kiyoshigawa/oMIDItone_Controller_V2/Controller PCB/Reverse Engineering Original Board/2019-04-23_Otamatone_Board_Photos/Board_Back.pdf

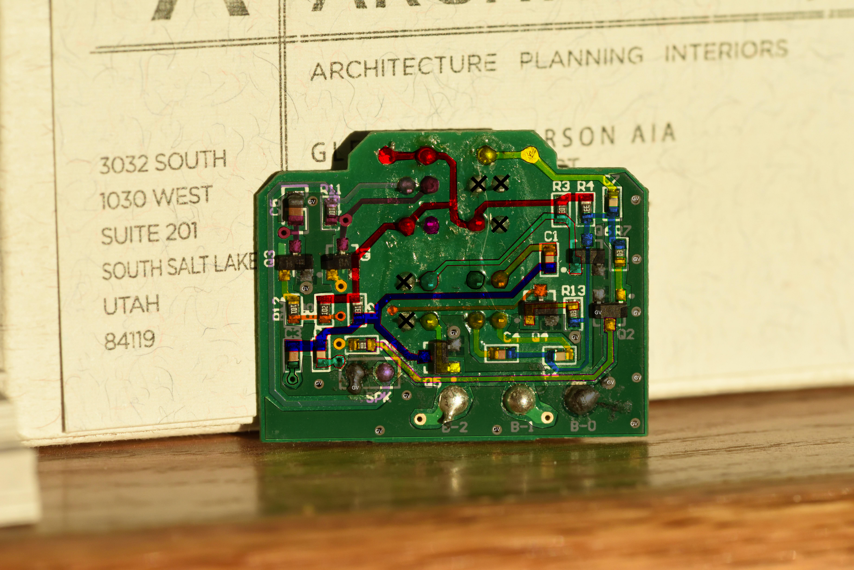
[picture p3: page 1]
