kiyoshigawa/oMIDItone_Controller_V2/Controller PCB/oMIDItone V2/oMIDItone V2 Schematic.pdf

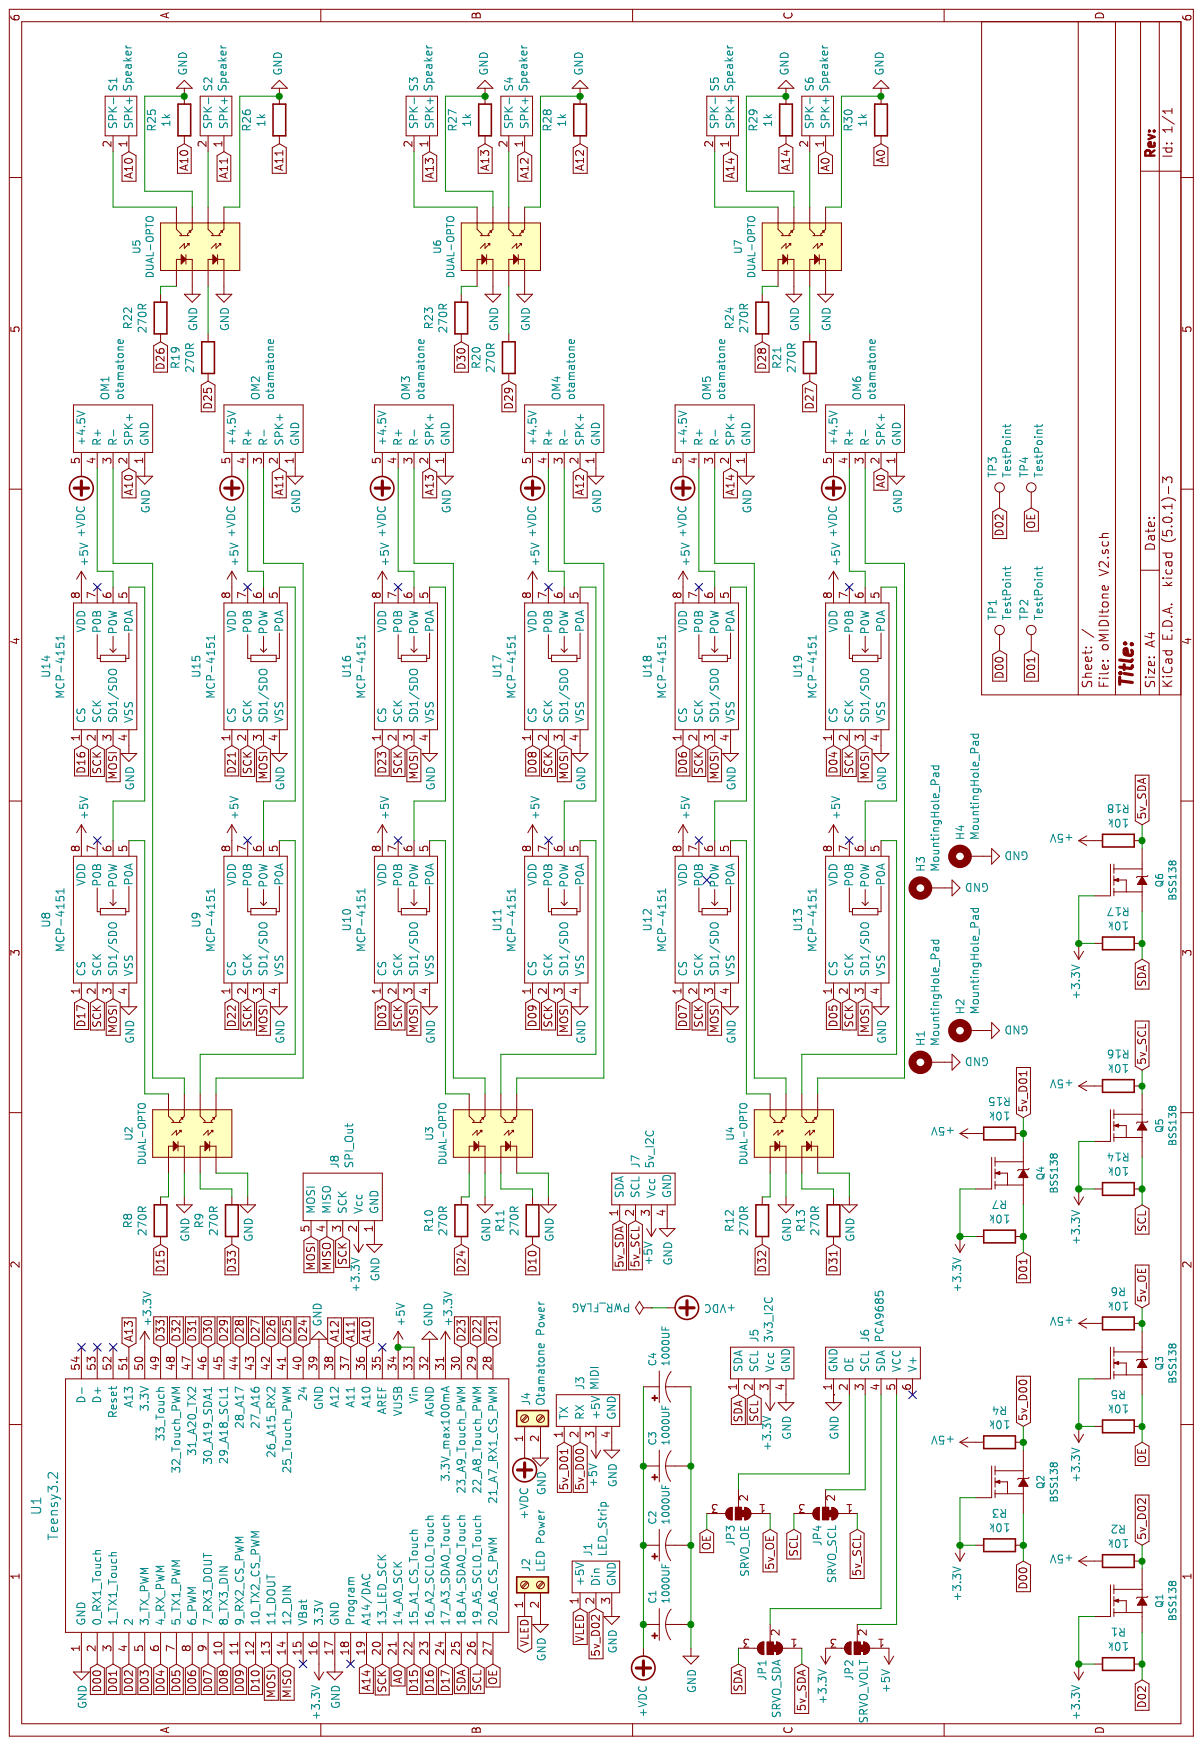
[picture p5: page 1]
