kiyoshigawa/oMIDItone_Controller_V2/Controller PCB/Reverse Engineering Original Board/RE-otamatone/RE-Otamatone-Schematic.pdf

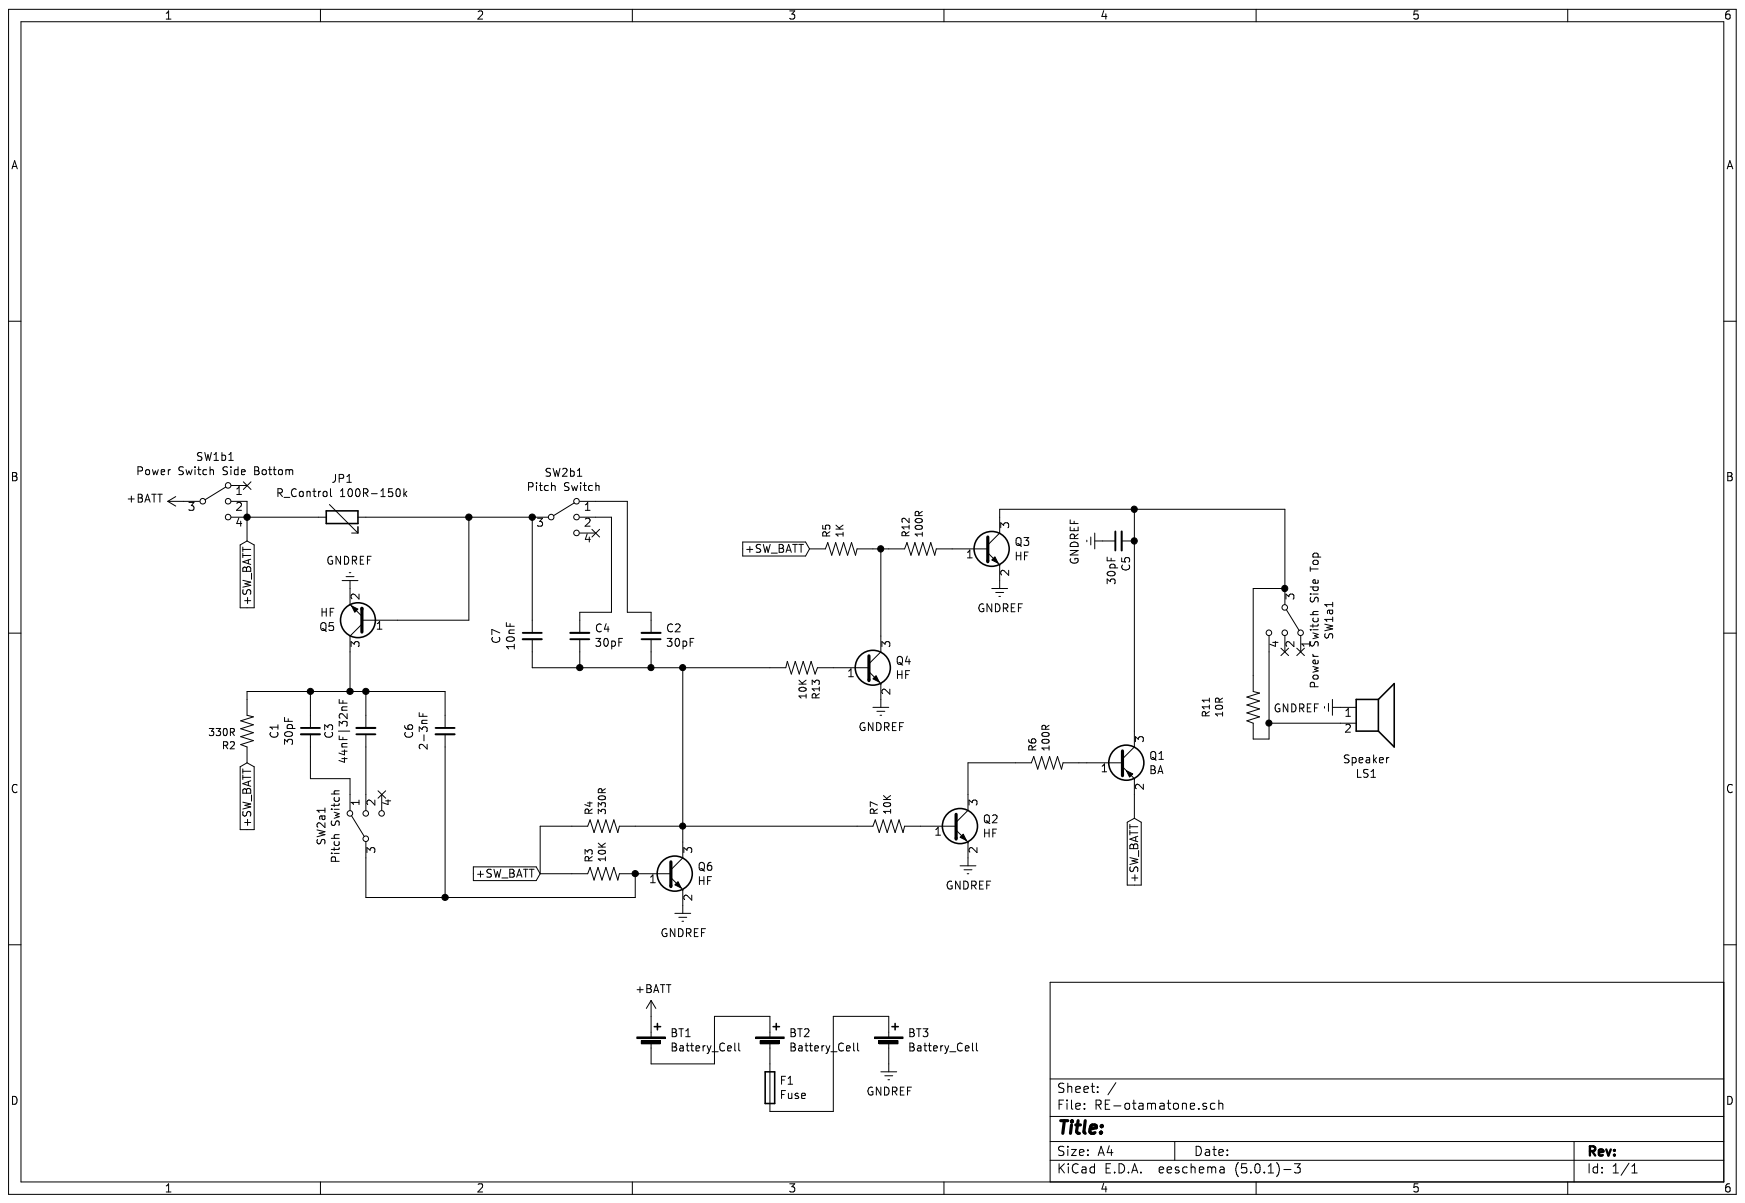
[picture p6: page 1]
