kiyoshigawa/oMIDItone_Controller_V2/include/oMIDItone.h

#define OMIDITONE_H
#include <Arduino.h>
#include <SPI.h>
#include <ADC.h>
#include <i2c_t3.h>
#include <Adafruit_PWMServoDriver.h>
#include "lighting_control.h"
#define OMIDITONE_DEBUG
#define FREQUENCY_CORRECTION_DEFAULT_ENABLE_STATE true
#define SERVO_DEFAULT_ENABLE_STATE true
#define NUM_OMIDITONES 6
#define NO_NOTE 128
#define NO_CHANNEL 17
#define NO_RESISTANCE -1
#define NOTE_A 440
#define NUM_MIDI_NOTES 128
#define NUM_MIDI_CHANNELS 16
#define NUM_RESISTANCE_STEPS 765
#define RISING_EDGE_THRESHOLD 50
#define ALLOWABLE_NOTE_ERROR 1
#define DEFAULT_MIDI_PITCH_BEND_SEMITONES 2
#define DEFAULT_MIDI_PITCH_BEND_CENTS 0
#define MAX_PITCH_BEND_SEMITONES 24
#define MAX_PITCH_BEND_CENTS 99
#define ALLOWABLE_FREQUENCY_READING_VARIANCE 50
#define MIN_TIME_BETWEEN_RISING_EDGE_MEASUREMENTS 1
#define NOTE_WAIT_TIME 10
#define TIME_BETWEEN_FREQUENCY_CORRECTIONS 20
#define JITTER 1
#define NUM_FREQ_READINGS 5
#define INIT_MULTIPLIER 17
#define TIME_TO_WAIT_FOR_INIT 2000
#define TIME_TO_WAIT_FOR_STARTUP_TEST_SOUND 100
#define NOTE_TIMEOUT 2000
#define UNREASONABLY_LARGE_MULTIPLIER 2
#define CENTER_PITCH_BEND 0
#define MAX_FREQ 300
#define PCA9685_ADDRESS 0x41
#define PCA9685_FREQUENCY 240
#define PCA9685_OE_PIN 20
#define NUM_LEDS_PER_HEAD 18
#define TIME_BETWEEN_SERVO_MOVEMENTS 16
#define CENT_FREQUENCY_RATIO_MULTIPLIER 1000000
const uint32_t midi_freqs[NUM_MIDI_NOTES] = {122309, 115446, 108968, 102848, 97077, 91633, 86490, 81632, 77053, 72727, 68643, 64792, 61154, 57723, 54484, 51427, 48538, 45814, 43243, 40816, 38525, 36363, 34322, 32396, 30578, 28861, 27242, 25712, 24270, 22907, 21622, 20408, 19262, 18181, 17161, 16198, 15289, 14430, 13621, 12856, 12134, 11453, 10810, 10204, 9631, 9090, 8580, 8099, 7644, 7215, 6810, 6428, 6067, 5726, 5405, 5102, 4815, 4545, 4290, 4049, 3822, 3607, 3405, 3214, 3033, 2863, 2702, 2551, 2407, 2272, 2145, 2024, 1911, 1803, 1702, 1607, 1516, 1431, 1351, 1275, 1203, 1136, 1072, 1012, 955, 901, 851, 803, 758, 715, 675, 637, 601, 568, 536, 506, 477, 450, 425, 401, 379, 357, 337, 318, 300, 284, 268, 253, 238, 225, 212, 200, 189, 178, 168, 159, 150, 142, 134, 126, 119, 112, 106, 100, 94, 89, 84, 79};
const uint32_t cent_frequency_ratios[199] = {1058851, 1058240, 1057629, 1057018, 1056408, 1055798, 1055188, 1054579, 1053970, 1053361, 1052753, 1052145, 1051537, 1050930, 1050323, 1049717, 1049111, 1048505, 1047899, 1047294, 1046689, 1046085, 1045481, 1044877, 1044274, 1043671, 1043068, 1042466, 1041864, 1041262, 1040661, 1040060, 1039459, 1038859, 1038259, 1037660, 1037060, 1036462, 1035863, 1035265, 1034667, 1034070, 1033472, 1032876, 1032279, 1031683, 1031087, 1030492, 1029897, 1029302, 1028708, 1028114, 1027520, 1026927, 1026334, 1025741, 1025149, 1024557, 1023965, 1023374, 1022783, 1022192, 1021602, 1021012, 1020423, 1019833, 1019244, 1018656, 1018068, 1017480, 1016892, 1016305, 1015718, 1015132, 1014545, 1013959, 1013374, 1012789, 1012204, 1011619, 1011035, 1010451, 1009868, 1009285, 1008702, 1008120, 1007537, 1006956, 1006374, 1005793, 1005212, 1004632, 1004052, 1003472, 1002892, 1002313, 1001734, 1001156, 1000578, 1000000, 999423, 998845, 998269, 997692, 997116, 996540, 995965, 995390, 994815, 994240, 993666, 993092, 992519, 991946, 991373, 990801, 990228, 989657, 989085, 988514, 987943, 987373, 986803, 986233, 985663, 985094, 984525, 983957, 983388, 982821, 982253, 981686, 981119, 980552, 979986, 979420, 978855, 978289, 977725, 977160, 976596, 976032, 975468, 974905, 974342, 973779, 973217, 972655, 972093, 971532, 970971, 970410, 969850, 969290, 968730, 968171, 967612, 967053, 966494, 965936, 965379, 964821, 964264, 963707, 963151, 962594, 962039, 961483, 960928, 960373, 959818, 959264, 958710, 958157, 957603, 957050, 956498, 955945, 955393, 954842, 954290, 953739, 953188, 952638, 952088, 951538, 950989, 950439, 949891, 949342, 948794, 948246, 947698, 947151, 946604, 946058, 945511, 944965, 944420};
class oMIDItone {
	public:
		oMIDItone(uint16_t signal_enable_optoisolator, uint16_t speaker_disable_optoisolator, uint16_t cs1, uint16_t cs2, uint16_t feedback, uint16_t servo_l_channel, uint16_t servo_r_channel, uint16_t servo_l_min, uint16_t servo_l_max, uint16_t servo_r_min, uint16_t servo_r_max, uint16_t led_head_array[NUM_LEDS_PER_HEAD], Animation * head_animation);
		void init();
		void update();
		bool note_on(uint16_t note, uint16_t velocity, uint16_t channel);
		void note_off(uint16_t note);
		void set_pitch_bend(int16_t pitch_bend_value, uint8_t pitch_bend_channel);
		void set_max_pitch_bend(uint8_t semitones, uint8_t cents);
		void cancel_pitch_correction();
		void set_servos(uint16_t position);
		bool is_running();
		uint16_t currently_playing_note();
		uint16_t currently_playing_pitch_bend(uint16_t channel);
		void enable_pitch_correction();
		void disable_pitch_correction();
		void enable_servos();
		void disable_servos();
		Animation * animation;
	private:
		bool startup_test();
		void measure_frequency();
		void adjust_frequency();
		bool can_play_note(uint8_t note, int16_t pitch_bend);
		uint32_t pitch_adjusted_frequency(uint8_t note, int16_t pitch_bend);
		void servo_update();
		bool is_rising_edge();
		uint32_t average(unsigned long * array, uint16_t num_elements);
		uint16_t frequency_to_resistance(uint16_t frequency);
		void set_jitter_resistance(uint16_t resistance, uint16_t jitter);
		void set_resistance(uint16_t resistance);
		void set_pot(uint16_t CS_pin, uint16_t command_byte);
		bool had_successful_init;
		bool pitch_correction_is_enabled;
		bool servo_is_enabled;
		uint16_t current_note;
		uint16_t current_velocity;
		uint16_t current_channel;
		uint16_t min_note;
		uint16_t max_note;
		uint32_t measured_freqs[NUM_RESISTANCE_STEPS];
		uint32_t recent_freqs[NUM_FREQ_READINGS];
		uint16_t freq_reading_index;
		uint32_t current_freq;
		uint32_t current_desired_freq;
		uint32_t max_pitch_bend_offset;
		elapsedMicros last_rising_edge;
		elapsedMillis last_adjust_time;
		elapsedMillis last_stabilize_time;
		elapsedMillis note_start_time;
		elapsedMillis startup_stabilization_began;
		elapsedMillis last_frequency_measurement;
		uint16_t last_analog_read;
		int16_t current_oMIDItone_pitch_bend[NUM_MIDI_CHANNELS];
		uint16_t current_resistance;
		uint16_t signal_enable_optoisolator_pin;
		uint16_t speaker_disable_optoisolator_pin;
		uint16_t cs1_pin;
		uint16_t cs2_pin;
		uint16_t analog_feedback_pin;
		ADC *adc = new ADC();
		uint16_t l_channel;
		uint16_t r_channel;
		uint16_t l_min;
		uint16_t l_max;
		uint16_t r_min;
		uint16_t r_max;
		Adafruit_PWMServoDriver servo_controller = Adafruit_PWMServoDriver(PCA9685_ADDRESS);
		elapsedMillis last_servo_update;
		bool pitch_correction_has_been_compromised;
		uint16_t * led_position_array;
};
