kiyoshigawa/oMIDItone_Controller_V2/(commit log)

2019-12-03 Initial Commit with 3rd Party Libraries
    [RE-otamatone.kicad_pcb, RE-otamatone.sch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]
2019-12-03 Weirdness with Adafruit Servo Git Commits Fixed
2019-12-03 First untested attempt at fixing oMIDItone class
    [main.cpp]
2019-12-03 cleaned up function brackets
2019-12-05 Lighting Controller to enums and switches
2019-12-10 Fixed Overflow Issues with add_note and remove_note
    [main.cpp]
2019-12-13 pitch bending and max pitch bend RPNs functional
2019-12-13 Error cleanup and staging for head assignments
    [main.cpp]
2019-12-14 fixed some CC handling bugs after testing
    [main.cpp]
2019-12-15 crashing when playing notes - debugging
    [main.cpp]
2019-12-15 fixed freq_reading_index out of bounds error
    [main.cpp]
2019-12-15 pitch correction fixed topping and bottoming out
2019-12-22 Removed free_mem() function, no longer needed.
    [main.cpp]
2020-08-29 Replaced bad servos, updated resting positions.
    [main.cpp]
