kiyoshigawa/oMIDItone_Controller_V2/(notices)

Notices in the files:
src/main.cpp:
This library is free software: you can redistribute it and/or modify
it under the terms of the GNU Lesser General Public License as published by
the Free Software Foundation, either version 3 of the License, or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
